zeus074/dfswitcher/attiny25.jpg

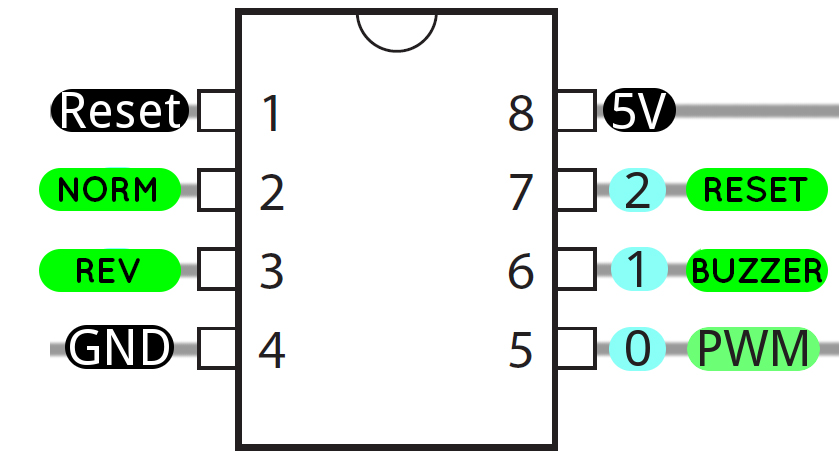
attiny25.jpg
