zeus074/dfswitcher/BOM_Amiga_DF0_1_selector_20200212122511.csv

ID | Name | Designator | Footprint | Quantity | Manufacturer Part | Manufacturer | Supplier | Supplier Part
1 | Chip | U4 | DIP40 | 1
2 | 10k | R1,R2 | R0805 | 2
3 | 560 | R3 | R0805 | 1
4 | Header-Male-2.54_1x3 | H1 | HDR-TH_3P-P2.54-V | 1 | Header2.54mm 1*3P | BOOMELE | LCSC | C49257
5 | 100nF | C1,C2 | R0805 | 2
6 | Header-Male-2.54_1x1 | RESET1 | HDR-1X1/2.54 | 1 | Header-Male-2.54_1x1 | ReliaPro | LCSC | C81276
7 | Board | J4,J3 | HDR-TH_20PIN-V-MALE-PITCH2.54 | 2 | 2.54mm 1*20PHeader | BOOMELE | LCSC | C50981
8 | CD4066 | U2 | SOP-14_L8.6-W3.9-P1.27-LS6.0-BL | 1
9 | BUZZER 5V 9x4.2mm | BUZZER | HDR-2X1/2.54 | 1 | https://it.aliexpress.com/item/32948360045.html?spm=a2g0s.9042311.0.0.27424c4du1lX57 | KY WIN ROBOT Store | Aliexpress
10 | JUMPER | SJ1 | SJW | 1
11 | ATtiny25-20SSH | U1 | SOIC8 | 1
