zeus074/dfswitcher/Schematic/Schematic_Amiga_DF0_1_selector_DF_switcher_20200212122104.pdf

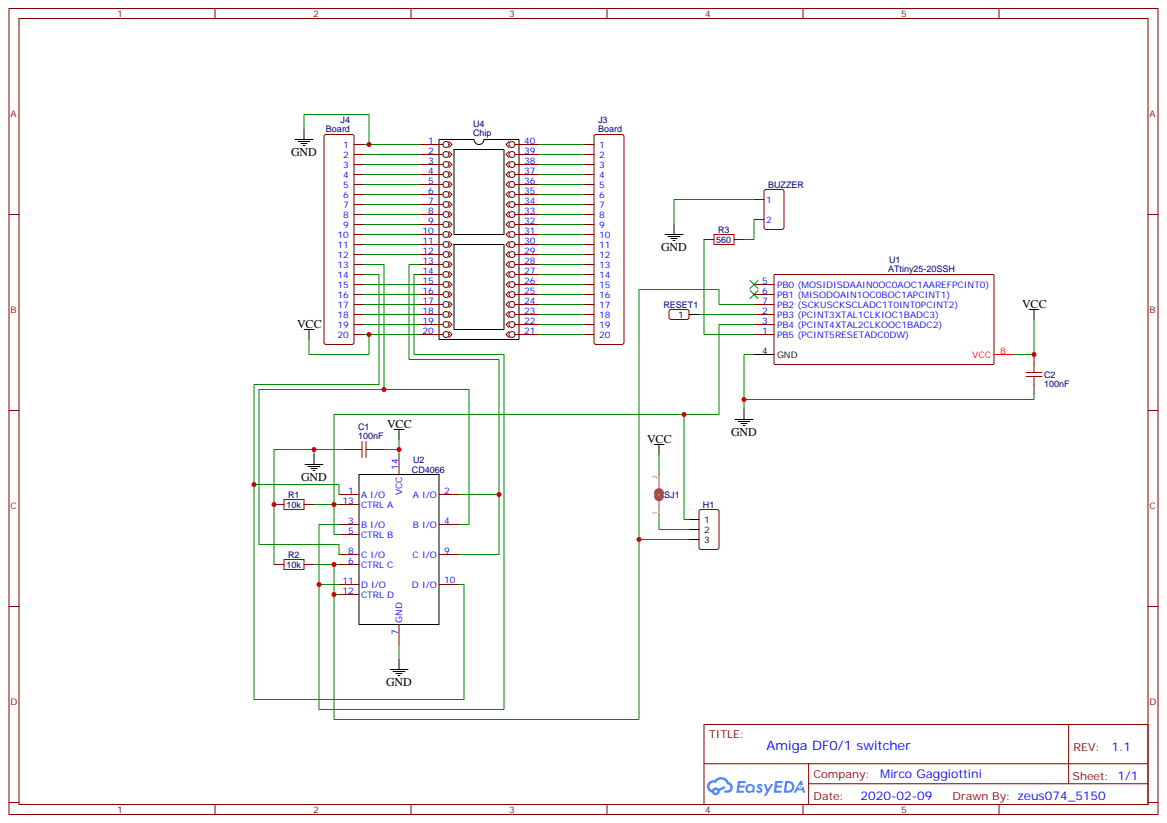
[picture p3: page 1]
