zeus074/dfswitcher/(threads)

Thread 1 (2022-08-23):

Buzzer part number?

dlxmax, 2022-08-23:
Hi, great project. I've got PCBs in front of me to build.
Could you please share the buzzer part number?
I'm having a hard time finding one with 5mm terminal pitch and a small enough diameter.
I'm also concerned about the height.
Thanks!

zeus074, 2022-10-15:
Unfortunately yes also I have not found such a buzer.
Initially I had thought of putting the classic ones by folding them at 90 degrees. then I thought about putting the little straight ones, but the pads stayed that way.
I fold them to weld them, as soon as I can I change the PCB.
Regards.

Thread 2 (2025-09-27):

Alternative Boot Switch Trigger

Rezamjj, 2025-09-27:
Hello,

First of all, thank you for sharing this great project. The current firmware uses the “double reset within 2 seconds” method to toggle the DF0 boot drive. I was wondering if it would be possible to add (or modify the firmware to support) an alternative trigger method — for example, holding down a key (such as the Esc key) for 5 seconds, or using a dedicated push button connected to an unused pin.

Would you consider adding such an option, or could you please share the firmware source code so that I (or others) could experiment with implementing this behavior?

Closed 2025-09-30.
