zeus074/dfswitcher/(commit log)

2021-10-22 initial upload
    [BOM_Amiga_DF0_1_selector_20200212122511.csv]
2025-09-30 source file
    Use with Arduino IDE
2025-09-30 Add gerber with icsp connector
